PrideLee/Wind-Pendulum/(list of files, cad)

Other CAD files:
tilt angle figure.dwg
