PrideLee/Wind-Pendulum/code/wind pendulum(version 1)/待处理bug.txt

特别注意！！！！！！！！
测试时，任何任务都要从静止开始测试，一定要保证在10秒内达到要求！！！！

bug清单：

1，画圆部分半径的参数待调
2，画斜线部分角度起摆速度太慢
3，网线不稳定，重新接一根
4，
