PrideLee/Wind-Pendulum/code/wind pendulum(version 2)/风力摆源代码/15.10.30发表/user/usart2.c

/******************** (C) COPYRIGHT 2012 WildFire Team **************************
 串口二重映射
**********************************************************************************/
#include "usart2.h"
#include <stdarg.h>
#include "delay.h"
char buf[512];	 //液晶屏数据缓冲区

/*
 * 函数名：USART2_Config
 * 描述  ：USART2 GPIO 配置,工作模式配置
 * 输入  ：无
 * 输出  : 无
 * 调用  ：外部调用
 */
void USART2_Config(void)
{
	GPIO_InitTypeDef GPIO_InitStructure;
	USART_InitTypeDef USART_InitStructure;

	/* config USART2 clock */
//	RCC_APB2PeriphClockCmd(RCC_APB2Periph_GPIOD, ENABLE);
	RCC_APB1PeriphClockCmd(RCC_APB1Periph_USART2, ENABLE);
	RCC_APB2PeriphClockCmd(RCC_APB2Periph_GPIOD | RCC_APB2Periph_AFIO,ENABLE);//开启端口D和复用功能时钟
	GPIO_PinRemapConfig(GPIO_Remap_USART2,ENABLE);//使能端口重映射
	/* USART2 GPIO config */
   /* Configure USART2 Tx (PD.05) as alternate function push-pull */
  GPIO_InitStructure.GPIO_Pin = GPIO_Pin_5;
  GPIO_InitStructure.GPIO_Mode = GPIO_Mode_AF_PP;
  GPIO_InitStructure.GPIO_Speed = GPIO_Speed_50MHz;
  GPIO_Init(GPIOD, &GPIO_InitStructure);
	    
  /* Configure USART2 Rx (PD.06) as input floating */
  GPIO_InitStructure.GPIO_Pin = GPIO_Pin_3;
  GPIO_InitStructure.GPIO_Mode = GPIO_Mode_IN_FLOATING;
  GPIO_Init(GPIOD, &GPIO_InitStructure);
	  
	/* USART2 mode config */
	USART_InitStructure.USART_BaudRate = 115200;
	USART_InitStructure.USART_WordLength = USART_WordLength_8b;
	USART_InitStructure.USART_StopBits = USART_StopBits_1;
	USART_InitStructure.USART_Parity = USART_Parity_No ;
	USART_InitStructure.USART_HardwareFlowControl = USART_HardwareFlowControl_None;
	USART_InitStructure.USART_Mode = USART_Mode_Rx | USART_Mode_Tx;

USART_Init(USART2, &USART_InitStructure); 
  USART_Cmd(USART2, ENABLE);
}

/*
 * 函数名：fputc
 * 描述  ：重定向c库函数printf到USART2
 * 输入  ：无
 * 输出  ：无
 * 调用  ：由printf调用
 */
//int fputc(int ch, FILE *f)
//{
///* 将Printf内容发往串口 */
//  USART_SendData(USART2, (unsigned char) ch);
//  while (!(USART2->SR & USART_FLAG_TXE));
// 
//  return (ch);
//}

/*
 * 函数名：itoa
 * 描述  ：将整形数据转换成字符串
 * 输入  ：-radix =10 表示10进制，其他结果为0
 *         -value 要转换的整形数
 *         -buf 转换后的字符串
 *         -radix = 10
 * 输出  ：无
 * 返回  ：无
 * 调用  ：被USART2_printf()调用
 */
static char *itoa2(int value, char *string, int radix)
{
    int     i, d;
    int     flag = 0;
    char    *ptr = string;

    /* This implementation only works for decimal numbers. */
    if (radix != 10)
    {
        *ptr = 0;
        return string;
    }

    if (!value)
    {
        *ptr++ = 0x30;
        *ptr = 0;
        return string;
    }

    /* if this is a negative value insert the minus sign. */
    if (value < 0)
    {
        *ptr++ = '-';

        /* Make the value positive. */
        value *= -1;
    }

    for (i = 10000; i > 0; i /= 10)
    {
        d = value / i;

        if (d || flag)
        {
            *ptr++ = (char)(d + 0x30);
            value -= (d * i);
            flag = 1;
        }
    }

    /* Null terminate the string. */
    *ptr = 0;

    return string;

} /* NCL_Itoa */

/*
 * 函数名：USART2_printf
 * 描述  ：格式化输出，类似于C库中的printf，但这里没有用到C库
 * 输入  ：-USARTx 串口通道，这里只用到了串口2，即USART2
 *		     -Data   要发送到串口的内容的指针
 *			   -...    其他参数
 * 输出  ：无
 * 返回  ：无 
 * 调用  ：外部调用
 *         典型应用USART2_printf( USART2, "\r\n this is a demo \r\n" );
 *            		 USART2_printf( USART2, "\r\n %d \r\n", i );
 *            		 USART2_printf( USART2, "\r\n %s \r\n", j );
 */
void USART2_printf(USART_TypeDef* USARTx, uint8_t *Data,...)
{
	const char *s;
  int d;   
  char buf[16];

  va_list ap;
  va_start(ap, Data);

	while ( *Data != 0)     // 判断是否到达字符串结束符
	{				                          
		if ( *Data == 0x5c )  //'\'
		{									  
			switch ( *++Data )
			{
				case 'r':							          //回车符
					USART_SendData(USARTx, 0x0d);
					Data ++;
					break;

				case 'n':							          //换行符
					USART_SendData(USARTx, 0x0a);	
					Data ++;
					break;
				
				default:
					Data ++;
				    break;
			}			 
		}
		else if ( *Data == '%')
		{									  //
			switch ( *++Data )
			{				
				case 's':										  //字符串
					s = va_arg(ap, const char *);
          for ( ; *s; s++) 
					{
						USART_SendData(USARTx,*s);
						while( USART_GetFlagStatus(USARTx, USART_FLAG_TC) == RESET );
          }
					Data++;
          break;

        case 'd':										//十进制
          d = va_arg(ap, int);
          itoa2(d, buf, 10);
          for (s = buf; *s; s++) 
					{
						USART_SendData(USARTx,*s);
						while( USART_GetFlagStatus(USARTx, USART_FLAG_TC) == RESET );
          }
					Data++;
          break;
				 default:
						Data++;
				    break;
			}		 
		} /* end of else if */
		else USART_SendData(USARTx, *Data++);
		while( USART_GetFlagStatus(USARTx, USART_FLAG_TC) == RESET );
	}
}
void GpuSend(char * buf1)
{  u8 i=0;
   while (1)
   {  if (buf1[i]!=0)
     {  
	 	USART_SendData(USART2, buf1[i]);  //发送一个byte到串口
        while(USART_GetFlagStatus(USART2, USART_FLAG_TXE) == RESET){}; //等待发送结束
        i++;
     }
     else return;
   }
}

void Display_Title(void)
{
	sprintf(buf,"CLS(0);DS16(6,02,'2015全国大学生电子设计竞赛',10);DS16(54,22,'风力摆控制系统',2);\r\n");//清屏函数；
	GpuSend(buf);
}
