PrideLee/Wind-Pendulum/code/wind pendulum(version 2)/风力摆源代码/15.10.30发表/user/LED.c

#include "LED.H"

void LED_GPIO_Config(void)
{
	GPIO_InitTypeDef IO_Init;
	RCC_APB2PeriphClockCmd(RCC_APB2Periph_GPIOE, ENABLE);	
	
	IO_Init.GPIO_Pin = GPIO_Pin_3 | GPIO_Pin_7 | GPIO_Pin_8 | GPIO_Pin_9;				    
	IO_Init.GPIO_Mode = GPIO_Mode_Out_PP;
	IO_Init.GPIO_Speed = GPIO_Speed_50MHz;	
	GPIO_Init(GPIOE, &IO_Init);	
	
	LED1OFF;
	LED2OFF;
	BEEPOFF;			 
}
