PrideLee/Wind-Pendulum/(notices)

Notices in the files:
code/wind pendulum(version 2)/风力摆_NO1/HARDWARE/IIC/myiic.c:
Copyright(C) ¹ãÖÝÊÐÐÇÒíµç×Ó¿Æ¼¼ÓÐÏÞ¹«Ë¾ 2014-2024
All rights reserved
code/wind pendulum(version 2)/风力摆_NO1/USMART/usmart.c:
Copyright(C) ÕýµãÔ­×Ó 2011-2021
code/wind pendulum(version 2)/风力摆_NO1/SYSTEM/usart/usart.c:
Copyright(C) ¹ãÖÝÊÐÐÇÒíµç×Ó¿Æ¼¼ÓÐÏÞ¹«Ë¾ 2009-2019
code/wind pendulum(version 2)/风力摆_NO1/SYSTEM/usart/usart.h:
Copyright(C) ÕýµãÔ­×Ó 2009-2019
